ToolboxBodensee/diy-copter-remote/doc/datasheets/tiny_frsky_8ch_receiver_pinout.png

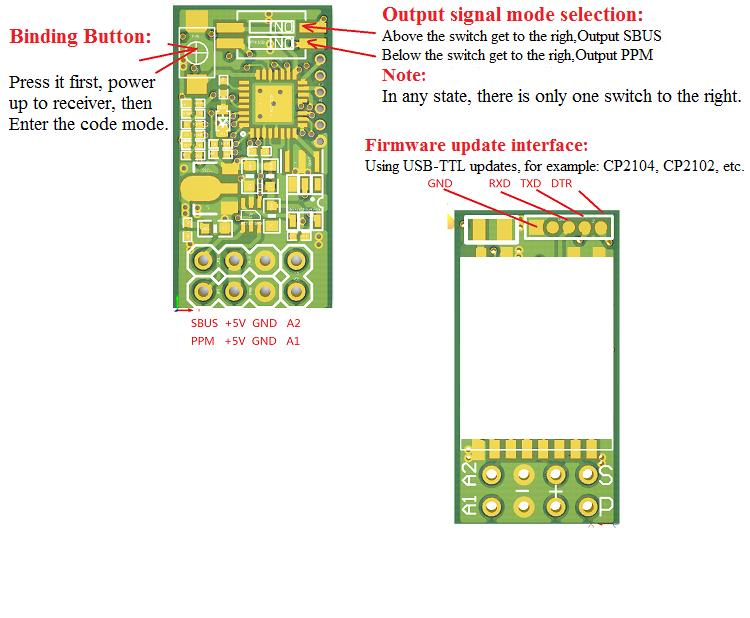
doc/datasheets/tiny_frsky_8ch_receiver_pinout.png
