ToolboxBodensee/diy-copter-remote/doc/remote/stm32_mod.jpg

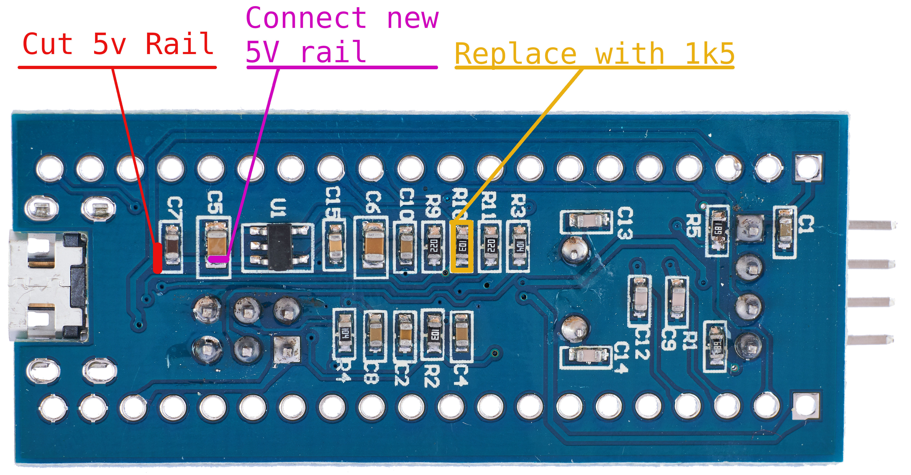
doc/remote/stm32_mod.jpg
