ToolboxBodensee/diy-copter-remote/doc/datasheets/pinout-pro_micro.jpg

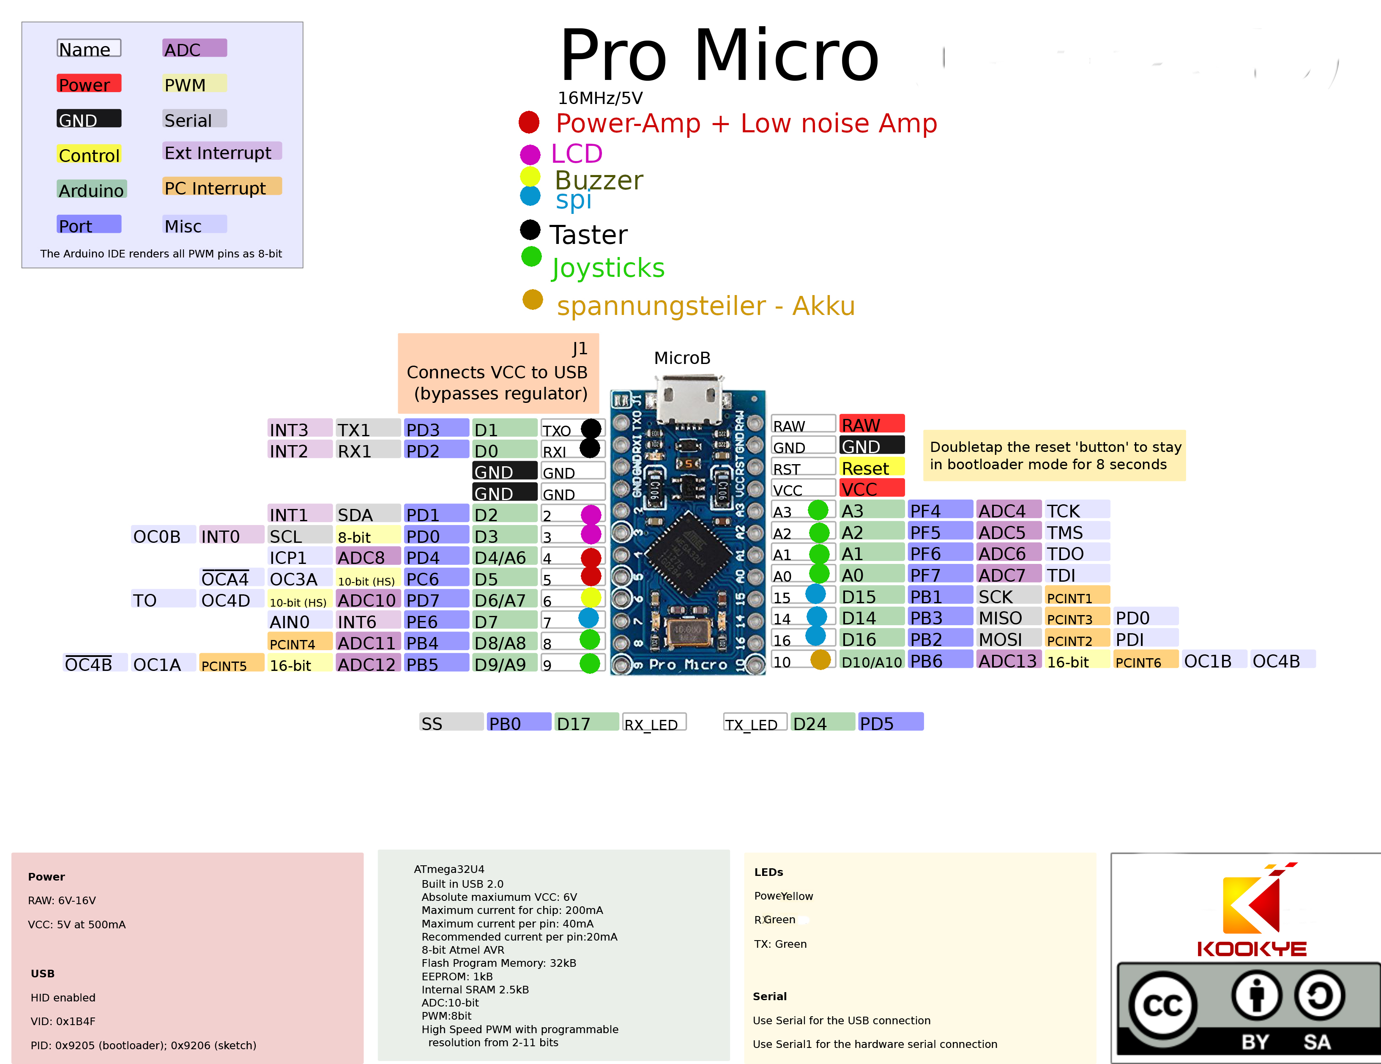
doc/datasheets/pinout-pro_micro.jpg
