ToolboxBodensee/diy-copter-remote/doc/coper/kosten.ods

Sheet: Kosten
Beschreibung | Link | Pro Teil Preis | Preis | Teile | Shop | Bestellung
Lötübungen
Linienfolgeroboter | DIY Robot (https://www.aliexpress.com/item/DIY-Robot-Smart-Car-Kit-Intelligent-Tracking-Line-Suite-TT-Motor-Electronic-Production-Tracing-Patrol-RC/32861091566.html) | $4.38 | $43.80 | 10
LED Tannenbaum | Three-Dimensional 3D Christmas Tree (https://www.aliexpress.com/item/Three-Dimensional-3D-Christmas-Tree-LED-DIY-Kit-Red-Green-Yellow-LED-Flash-Circuit-Kit-Electronic/32872841465.html) | $3.67 | $36.68 | 10
Quadrocopter + Funke für 5 kids + ersatz wegen china/kaputtlöten = 10 sets
Quadrocopter receiver | New Arrival Tiny Frsky 8CH Receiver Compatible With FRSKY X9D Plus DJT DFT DHT For QX90 DIY Micro Quadcopter (https://www.aliexpress.com/item/New-Arrival-Tiny-Frsky-8CH-Receiver-Compatible-With-FRSKY-X9D-Plus-DJT-DFT-DHT-For-QX90/32825660138.html) | $7.89 | $23.68 | 3 | aliexpress | 1
Funken Sender | CC2500 PA LNA (https://www.aliexpress.com/item/CC2500-PA-LNA-Romote-Wireless-Module-CC2500-SI4432-For-RC-Quadcopter-Helicopter-Multirotor-Model-Parts/32740098548.html) | $4.93 | $29.58 | 6 | aliexpress | 1
Funken Gas Hebel | Fast Free Ship 20pcs Potentiometer/Aircraft game 10K Throttle (https://www.aliexpress.com/item/Fast-Free-Ship-20pcs-Potentiometer-Aircraft-game-10K-Throttle-Potentiometer-Rocker-and-Joysticks/32652387867.html) | $1.45 | $28.93 | 20 | aliexpress | 1
Funken LCD | Geekcreit® IIC / I2C 1602 Blue Backlight LCD Display Screen... (https://www.banggood.com/IIC-I2C-1602-Blue-Backlight-LCD-Display-Module-For-Arduino-p-950726.html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) | $3.91 | $15.64 | 4 | bangood | 2
Propeller schwarz | 10 Pairs Kingkong 65mm Blade Propeller Prop 20Pcs for 720 8520 Coreless Motor DIY Micro Quadcopter (https://www.banggood.com/10-Pairs-Kingkong-65mm-Blade-Propeller-Prop-20Pcs-for-720-8520-Coreless-Motor-DIY-Micro-Quadcopter-p-1092166.html) | $4.99 | $9.98 | 2 | bangood | 2
Funken Sender | CC2500 PA LNA (https://www.banggood.com/CC2500-PA-LNA-Romote-Wireless-Module-CC2500-SI4432-NRF24L01-p-922595.html) | $4.69 | $23.45 | 5 | bangood | 2
Versandkosten | Bangood – Bestellnummer 2 | $3.03 | $3.03 | 1 | bangood | 2
Quadrocopter LED | Eachine Lizard105S FPV Racing Drone Spare Part Ultralight Colorful LED Alarm Buzzer WS2812B Programa (https://www.banggood.com/Eachine-Lizard105S-FPV-Racing-Drone-Spare-Part-Ultralight-Colorful-LED-Alarm-Buzzer-WS2812B-Programa-p-1262951.html) | $2.73 | $10.92 | 4 | bangood | 3
Quadrocopter receiver | Tiny Frsky 8CH Receiver Compatible With FRSKY X9D (https://www.banggood.com/Tiny-Frsky-8CH-Receiver-Compatible-With-FRSKY-X9D-Plus-DJT-DFT-DHT-For-QX90-DIY-Micro-Quadcopter-p-1079963.html) | $8.61 | $34.44 | 4 | bangood | 3
Quadrocopter FC/ESC | Realacc F3 V1.0 Betaflight Brushed Flight Control Board Integrated OSD with Buzzer STM32 F303 (https://www.banggood.com/Realacc-F3-V1_0-Betaflight-Brushed-Flight-Control-Board-Integrated-OSD-with-Buzzer-STM32-F303-MPU600-p-1121378.html) | $15.47 | $61.88 | 4 | bangood | 3
Quadrocopter Motoren | 4X Racerstar 8520 8.5x20mm 53500RPM Coreless Motor for Eachine QX80 DIY FPV Quadcopter (https://www.banggood.com/4X-Racerstar-8520-8_5x20mm-53500RPM-Coreless-Motor-for-Eachine-QX80-QX90-QX95-DIY-FPV-Quadcopter-p-1114280.html) | $12.53 | $50.12 | 4 | bangood | 3
Quadrocopter USB Ladegerät | 6CH USB To 3.7V 1S Lipo Battery Charging Adapter Board (https://www.banggood.com/6CH-USB-To-3_7V-1S-Lipo-Battery-Charging-Adapter-Board-p-1195277.html) | $4.40 | $35.20 | 8 | bangood | 3
Versandkosten | Bangood – Bestellnummer 3 | $6.53 | $6.53 | 1 | bangood | 3
Funken LCD I2c Controller | 5Pcs IIC/I2C/TWI/SPI Serial Port Module 5V 1602LCD Display For... (https://www.banggood.com/5Pcs-IICI2CTWISP-Serial-Module-Port-For-5V-Arduino-1602LCD-Display-p-964315.html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) | $0.89 | $4.46 | 5 | bangood | 4
Quadrocopter USB Ladegerät | 6CH USB To 3.7V 1S Lipo Battery Charging Adapter Board (https://www.banggood.com/6CH-USB-To-3_7V-1S-Lipo-Battery-Charging-Adapter-Board-p-1195277.html?rmmds=myorder) | $4.69 | $9.38 | 2 | bangood | 5
Funken Schalter | Wendao MTS-102 ON/ON SPDT AC 125V 6A 3 Pins Toggle Rocker Switch... (https://www.banggood.com/Wendao-MTS-102-ONON-SPDT-AC-125V-6A-3-Pins-Toggle-Rocker-Switch-10pcs-p-1060404.html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) | $0.37 | $18.55 | 50 | bangood | 6
Funken Hebel ( nick /Roll) | 20Pcs PS2 Game Joystick Module For Arduino (https://www.banggood.com/20Pcs-PS2-Game-Joystick-Module-For-Arduino-p-951191.html?rmmds=myorder) | $0.75 | $14.99 | 20 | bangood | 7
Quadrocopter USB Ladegerät | 6CH USB To 3.7V 1S Lipo Battery Charging Adapter Board (https://www.banggood.com/6CH-USB-To-3_7V-1S-Lipo-Battery-Charging-Adapter-Board-p-1195277.html?rmmds=myorder) | $4.69 | $9.38 | 2 | bangood | 8
Quadrocopter LED | Eachine Lizard105S FPV Racing Drone Spare Part Ultralight... (https://www.banggood.com/Eachine-Lizard105S-FPV-Racing-Drone-Spare-Part-Ultralight-Colorful-LED-Alarm-Buzzer-WS2812B-Programa-p-1262951.html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) | $2.73 | $16.38 | 6 | bangood | 8
Funken Antenne | 5pcs 2.4GHz 6dBi 50ohm Wireless Wifi Omni Copper Dipole Antenna (https://www.banggood.com/5pcs-2_4GHz-6dBi-50ohm-Wireless-Wifi-Omni-Copper-Dipole-Antenna-SMA-To-IPEX-For-Monitoring-Router-p-1214974.html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) | $2.24 | $22.42 | 10 | bangood | 9
Versandkosten | Bangood – Bestellnummer 9 | $0.67 | $0.67 | 1 | bangood | 9
Quadrocopter USB Ladegerät | 6CH USB To 3.7V 1S Lipo Battery Charging Adapter Board (https://www.banggood.com/6CH-USB-To-3_7V-1S-Lipo-Battery-Charging-Adapter-Board-p-1195277.html?rmmds=myorder) | $4.69 | $9.38 | 2 | bangood | 10
Propeller rot | 10 Pairs Kingkong 65mm Blade Propeller Prop 20Pcs for 720 8520... (https://www.banggood.com/10-Pairs-Kingkong-65mm-Blade-Propeller-Prop-20Pcs-for-720-8520-Coreless-Motor-DIY-Micro-Quadcopter-p-1092166.html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) | $2.99 | $8.97 | 3 | bangood | 10
Propeller schwarz | 10 Pairs Kingkong 65mm Blade Propeller Prop 20Pcs for 720 8520... (https://www.banggood.com/10-Pairs-Kingkong-65mm-Blade-Propeller-Prop-20Pcs-for-720-8520-Coreless-Motor-DIY-Micro-Quadcopter-p-1092166.html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) | $2.99 | $8.97 | 3 | bangood | 10
Quadrocopter receiver | Tiny Frsky 8CH Receiver Compatible With FRSKY X9D Plus DJT DFT... (https://www.banggood.com/Tiny-Frsky-8CH-Receiver-Compatible-With-FRSKY-X9D-Plus-DJT-DFT-DHT-For-QX90-DIY-Micro-Quadcopter-p-1079963.html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) | $8.61 | $34.44 | 4 | bangood | 10
Funken Controller | 5Pcs STM32F103C8T6 Small System Board Microcontroller STM32 ARM.. (https://www.banggood.com/5Pcs-STM32F103C8T6-Small-System-Board-Microcontroller-STM32-ARM-Core-Board-For-Arduino-p-1163842.html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) | $2.78 | $27.78 | 10 | bangood | 10
Quadrocopter Motoren | 4X Racerstar 8520 8.5x20mm 53500RPM Coreless Motor for Eachine (https://www.banggood.com/4X-Racerstar-8520-8_5x20mm-53500RPM-Coreless-Motor-for-Eachine-QX80-QX90-QX95-DIY-FPV-Quadcopter-p-1114280.html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) | $12.53 | $75.18 | 6 | bangood | 10
Quadrocopter FC/ESC | Realacc F3 V1.0 Betaflight Brushed Flight Control Board (https://www.banggood.com/Realacc-F3-V1_0-Betaflight-Brushed-Flight-Control-Board-Integrated-OSD-with-Buzzer-STM32-F303-MPU600-p-1121378.html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) | $15.47 | $92.82 | 6 | bangood | 10
Versandkosten | Bangood – Bestellnummer 10 | $7.84 | $7.84 | 1 | bangood | 10
Funken Spannungsversorgung | 5V 2.1A Charge Discharge Boost Power Modul 3.7V 4.2V Li-Ion 18650 LED Akku (https://www.ebay.de/itm/5V-2-1A-Charge-Discharge-boost-Power-Module-3-7V-4-2V-li-ion-18650-LED-battery/332653510696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) | 2.20 € | 13.22 € | 6 | ebay | 11
Funken Spannungsversorgung | 5V 2.1A Charge Discharge Boost Power Modul 3.7V 4.2V Li-Ion 18650 LED Akku (https://www.ebay.de/itm/5V-2-1A-Charge-Discharge-boost-Power-Module-3-7V-4-2V-li-ion-18650-LED-battery/332653510696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) | 2.20 € | 8.81 € | 4 | ebay | 12
Quadrocopter Akku | https://hobbyking.com/de_de/turnigy-nano-tech-750mah-1s-35-70c-lipo-pack-walkera-v120d02s-qr-infra-x-qr-w100s.html | 2.98 € | 62.58 € | 21 | hobbyking | 13
Quadrocopter Akku | https://hobbyking.com/de_de/turnigy-nano-tech-750mah-1s-35-70c-lipo-pack-walkera-v120d02s-qr-infra-x-qr-w100s.html | 2.94 € | 61.74 € | 21 | hobbyking | 14
Prototyp |  | #DIV/0!
Quadrocopter FC/ESC | Realacc F3 V1.0 Betaflight Brushed Flight Control Board Integrated OSD with Buzzer STM32 F303 MPU600 (https://www.banggood.com/Realacc-F3-V1_0-Betaflight-Brushed-Flight-Control-Board-Integrated-OSD-with-Buzzer-STM32-F303-MPU600-p-1121378.html) | 14.13 € | 14.13 € | 1 | bangood | 13
Versandkosten | Bangood – Bestellnummer 13 | 3.32 € | 3.32 € | 1 | bangood | 13
Quadrocopter akku | 6PCS ZOP POWER 3.7V 600mAh 30C 1S Lipo Battery JST Plug With... (https://www.banggood.com/6PCS-ZOP-POWER-3_7V-600mAh-30C-1S-Lipo-Battery-JST-Plug-With-Charger-For-RC-Models-p-1329943.html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) | 15.01 € | 15.01 € | 1 | bangood | 14
Versandkosten | Bangood – Bestellnummer 14 | 2.73 € | 2.73 € | 1 | bangood | 14
Propeller rot | 10 Pairs Kingkong 65mm Blade Propeller Prop 20Pcs for 720 8520 (https://www.banggood.com/10-Pairs-Kingkong-65mm-Blade-Propeller-Prop-20Pcs-for-720-8520-Coreless-Motor-DIY-Micro-Quadcopter-p-1092166.html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) | 4.41 € | 4.41 € | 1 | bangood | 15
Propeller schwarz | 10 Pairs Kingkong 65mm Blade Propeller Prop 20Pcs for 720 8520... (https://www.banggood.com/10-Pairs-Kingkong-65mm-Blade-Propeller-Prop-20Pcs-for-720-8520-Coreless-Motor-DIY-Micro-Quadcopter-p-1092166.html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) | 4.41 € | 4.41 € | 1 | bangood | 15
Quadrocopter receiver | Tiny Frsky 8CH Receiver Compatible With FRSKY X9D Plus DJT DFT... (https://www.banggood.com/Tiny-Frsky-8CH-Receiver-Compatible-With-FRSKY-X9D-Plus-DJT-DFT-DHT-For-QX90-DIY-Micro-Quadcopter-p-1079963.html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) | 7.94 € | 7.94 € | 1 | bangood | 15
Quadrocopter Motoren | 4X Racerstar 8520 8.5x20mm 53500RPM Coreless Motor for Eachine. (https://www.banggood.com/4X-Racerstar-8520-8_5x20mm-53500RPM-Coreless-Motor-for-Eachine-QX80-QX90-QX95-DIY-FPV-Quadcopter-p-1114280.html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) | 11.48 € | 11.48 € | 1 | bangood | 15
Versandkosten | Bangood – Bestellnummer 15 | 3.91 € | 3.91 € | 1 | bangood | 15
Funken Spannungsversorgung | 3Pcs LM2596 DC-DC Adjustable Step Down Power Supply Module (https://www.banggood.com/3Pcs-LM2596-DC-DC-Adjustable-Step-Down-Power-Supply-Module-p-1029697.html) | 3.31 € | 3.31 € | 1 | bangood | 16
Logic Konverter | RobotDyn® 4 Chanels Logic Level Converter High Speed Bi-Directional 3.3V-5V (https://www.banggood.com/4-Chanels-Logic-Level-Converter-High-Speed-Bi-Directional-3_3V-5V-p-1243719.html) | 1.29 € | 1.29 € | 1 | bangood | 16
Quadrocopter Antenne | 3DBI Brass 2.4G Receiver Antenna Omni Directional IPEX Port Compatible Futaba JR WFLY (https://www.banggood.com/3DBI-Brass-2_4G-Receiver-Antenna-Omnidirectional-IPEX-Port-Compatible-Futaba-JR-WFLY-p-1032401.html) | 1.37 € | 1.37 € | 1 | bangood | 16
Funken Joysticks | 5Pcs PS2 Game Joystick Module For Arduino (https://www.banggood.com/5Pcs-PS2-Game-Joystick-Module-For-Arduino-p-951186.html) | 4.15 € | 4.15 € | 1 | bangood | 16
Funken Controller | Pro Micro 5V 16M Mini Leonardo Microcontroller Development Board For Arduino (https://www.banggood.com/Pro-Micro-5V-16M-Mini-Leonardo-Microcontroller-Development-Board-For-Arduino-p-1077675.html) | 6.72 € | 6.72 € | 1 | bangood | 16
Funken Sender | CC2500 PA LNA Romote Wireless Module CC2500 SI4432 (https://www.banggood.com/CC2500-PA-LNA-Romote-Wireless-Module-CC2500-SI4432-NRF24L01-p-922595.html) | 4.41 € | 4.41 € | 1 | bangood | 16
Versandkosten | Bangood – Bestellnummer 16 | 2.48 € | 2.48 € | 1 | bangood | 16
PLA Filament |  | 23.99 € | 47.98 € | 2 | amazon
 |  | SUMME | $775.47
 |  |  | 285.40 €
 |  | Umrechnungkurs Dollar zu Euro (stand 20 Dec)
 |  | 0,87
 |  | SUMME | 960.06 €

Sheet: Zeiten
Bescreibung | Datum | Stunden | Philipp |  | Thomas |  | Alex |  | Mara
Vorbereitung
Teile zusammenstellen + Bestellungen |  | 7 | x | 7 | x | 7 |  | 0 |  | 0
Prototypen 3d model |  | 10 | x | 10 | x | 10 |  | 0 |  | 0
Programmierung Funke |  | 18 | x | 18 |  | 0 | x | 18 |  | 0
Kurszusammenstellung |  | 5 | x | 5 | x | 5 | x | 5 |  | 0
Bescreibung | Datum | Stunden | Philipp | 0 | Thomas |  | Alex |  | Mara
Kurs Inhalt
Kurs 1 Kennenlernen | 08.11.18 | 2 | x | 2 | x | 2 | x | 2 | x | 2
Kurs 2 Simulator | 15.11.18 | 2 | x | 2 | x | 2 | x | 2 | x | 2
Kurs 3 Lötkolben | 22.11.18 | 2 | x | 2 | x | 2 | x | 2 | x | 2
Kurs 4 Linien-folge | 29.11.18 | 2 | x | 2 | x | 2 | x | 2 | x | 2
Kurs 5 Linien-folge | 06.12.18 | 3 | x | 3 | x | 3 | x | 3 | x | 3
Kurs 6 Weihnachtsledbaum | 13.12.18 | 2 | x | 2 |  | 0 | x | 2 | x | 2
Kurs 7 Weihnachtsledbaum | 20.12.18 | 2 | x | 2 | x | 2 | x | 2 | x | 2
Kurs 8 Quadrocopter | 10.01.19 | 2 | x | 2 | x | 2 | x | 2 | x | 2
Kurs 9 Holzgehäuse für die Fernsteuerung | 17.01.19 | 2 | x | 2 | x | 2 | x | 2 | x | 2
Kurs 10 Löten Fernsteuerung | 24.01.19 | 2 | x | 2 | x | 2 | x | 2 | x | 2
Kurs 11 Fernsteuerung | 31.01.19 | 2 | x | 2 | x | 2 | x | 2 | x | 2
Kurs 12 Erstes Fliegen | 07.02.19 | 2 | x | 2 | x | 2 | x | 2 | x | 2
Kurs 13 Manövrieren des Quadrocopters | 14.02.19 | 2 | x | 2 | x | 2 | x | 2 | x | 2
Kurs 14 Manövrieren des Quadrocopters | 21.02.19 | 2 | x | 2 | x | 2 | x | 2 | x | 2
Kurs 15 Wettrennen? | 28.02.19 | 2 | x | 2 | x | 2 | x | 2 | x | 2
SUMME |  |  | 71 | 0 | 51 |  | 54 |  | 31
