ToolboxBodensee/diy-copter-remote/3d/quad_plug.stl

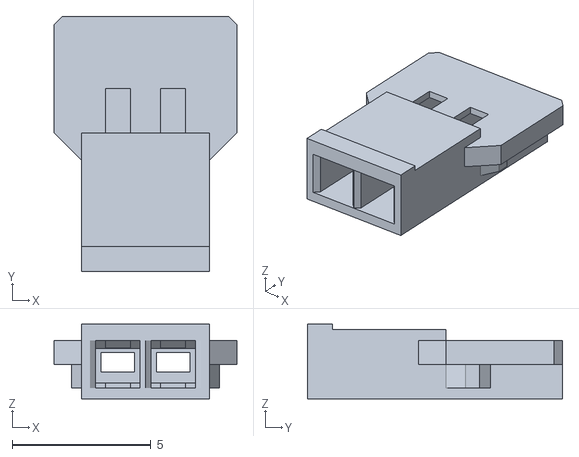
[picture p4: CAD file, 2019-02-28]
3d/quad_plug.stl
6.60 x 9.20 x 2.70
