ToolboxBodensee/diy-copter-remote/(list of files, cad)

Other CAD files:
3d/510050200.stp
