ToolboxBodensee/diy-copter-remote/doc/remote/remote_eschema.pdf

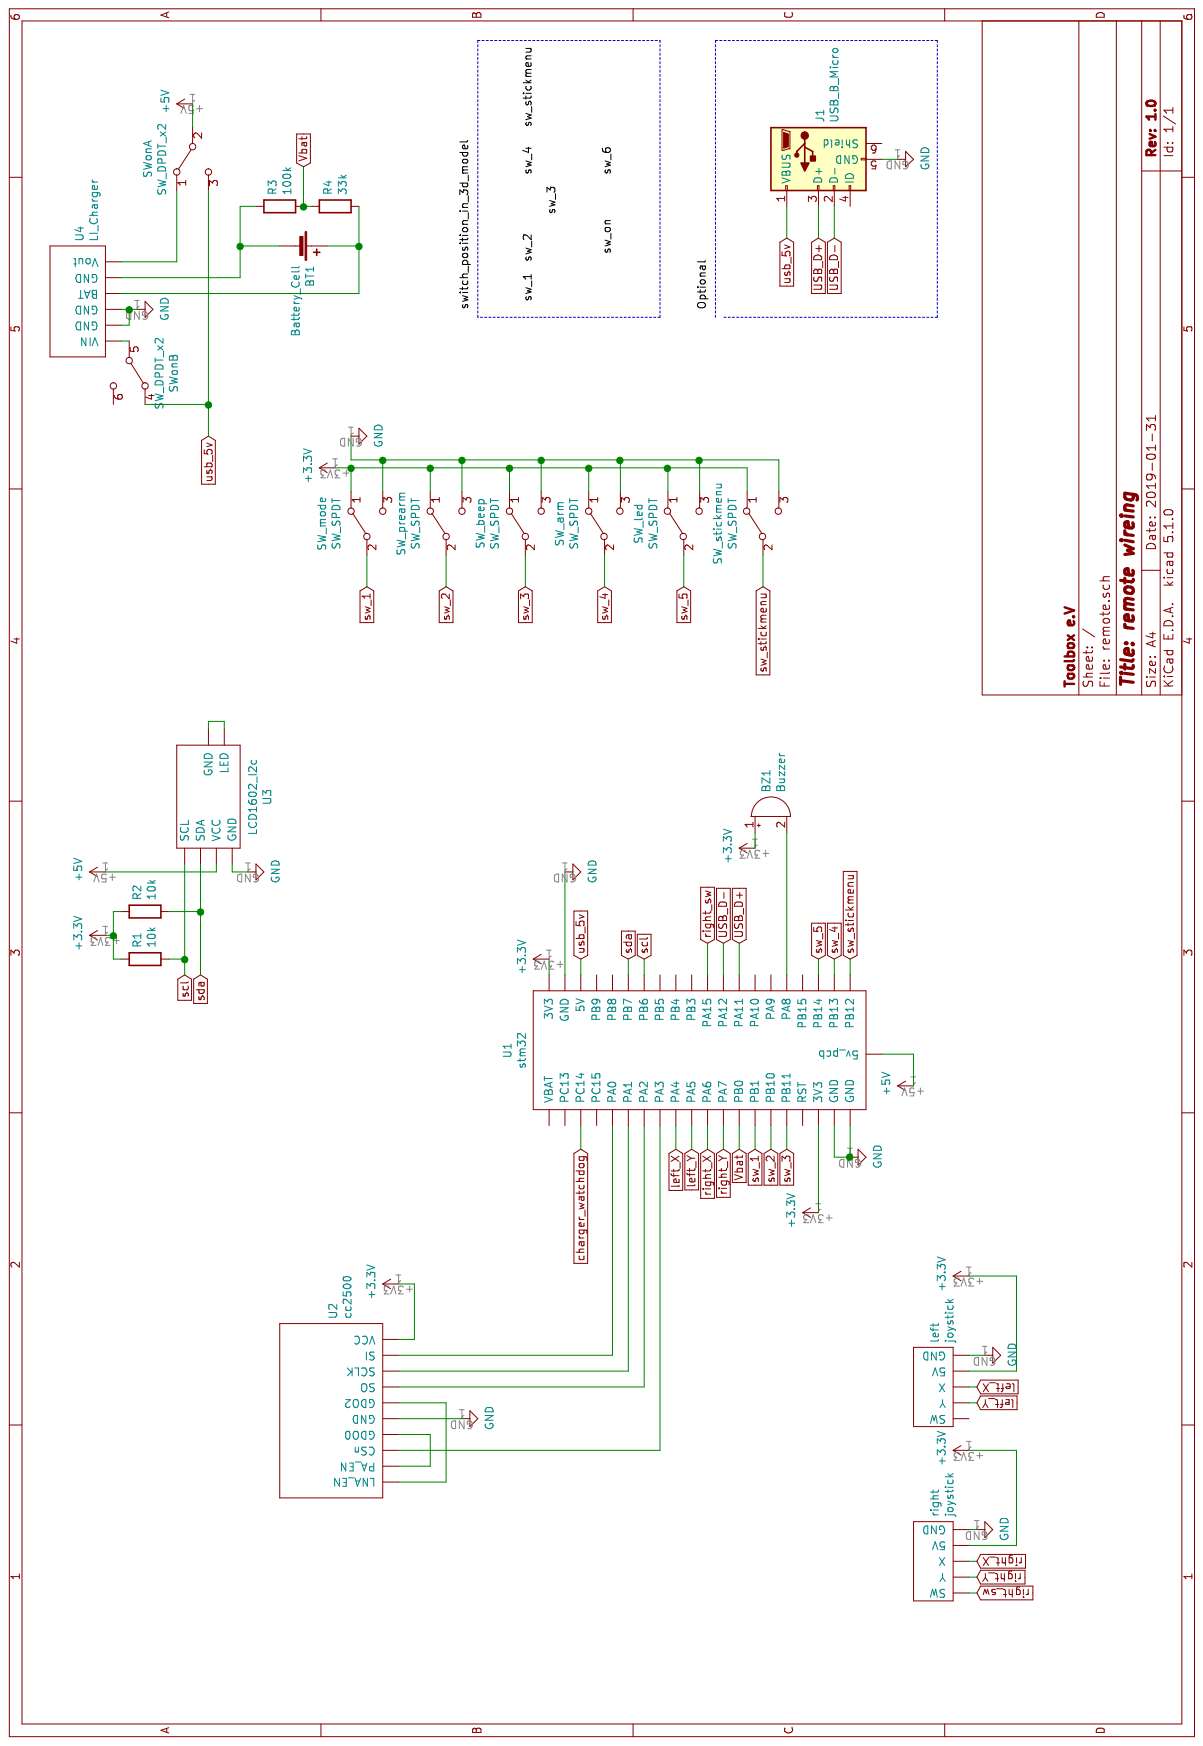
[picture p5: page 1]
