ToolboxBodensee/diy-copter-remote/remote/include/tx_def.h

#ifndef _TX_DEV_H_
#define _TX_DEV_H_

//Channel MIN MAX values
#define CHANNEL_MAX_100 1844    //  100%
#define CHANNEL_MIN_100 204     //  100%
#define CHANNEL_MAX_125 2047    //  125%
#define CHANNEL_MIN_125 0       //  125%

#define CHANNEL_MIN_COMMAND 784     // 1350us
#define CHANNEL_SWITCH      1104    // 1550us
#define CHANNEL_MAX_COMMAND 1424    // 1750us

//Channel definitions


#endif /* _TX_DEV_H_ */
