ToolboxBodensee/diy-copter-remote/remote/src/state_init.cpp

#include <LiquidCrystal_I2C.h>
#include <stdio.h>
#include "Arduino.h"
#include "FrSkyD_cc2500.h"
#include "state.h"
#include "input.h"
#include "eeprom.h"
#include "debug.h"
#include "config.h"
#include "pins.h"
#include "tx_def.h"

LCD_state_init::LCD_state_init(void) {
}
void LCD_state_init::enter(void) {
    lcd.clear();
    lcd.setCursor(0,0);
    lcd.print("     welcome    ");
    lcd.setCursor(0,1);
    lcd_centerText(REMOE_OWNER);

    this->time_enter = millis();
    BUZZER_output;

    /* for(int i = 0 ; i < 10;++i) { */
    /*     delay(100); */
    /*     BUZZER_on; */
    /*     delay(100); */
    /*     BUZZER_off; */
    /*     delay(100); */
    /* } */
}

void LCD_state_init::update(void)
{
    uint32_t diff;
    delay(100);
    diff = millis() - this->time_enter;
    if (diff > 3 * 1000) {
        new_state = s_joy;
        debugln("read start");
        delay(1000);
        if ( 0  > eeprom_config.read()) {
            debugln("failed to read");
            return;
        }
        debugln("read fin");

        debugln("val start");
        if ( 0  > eeprom_config.validate()) {
            debugln("failed to validate");
            return;
        }
        debugln("val fin");

        new_state = s_menu;

        struct Input::ch_config ch_config[Input::CH_COUNT];
        eeprom_config.get_ch_config(ch_config);
        input.set_calibration(ch_config);

        uint32_t master_id = 0;
        eeprom_config.get_master_id(&master_id);
        set_rx_tx_addr(master_id);

        uint8_t freq_ = 0;
        eeprom_config.get_freq_offset(&freq_);
        freq_offset = freq_;

    }
}

void LCD_state_init::leave(void)
{
    lcd.clear();
}
