ToolboxBodensee/diy-copter-remote/Multiprotocol/FrSkyV_cc2500.ino

/*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
 You should have received a copy of the GNU General Public License
 along with Multiprotocol.  If not, see <http://www.gnu.org/licenses/>.
 */

#if defined(FRSKYV_CC2500_INO)

#define FRSKYV_BIND_COUNT 200

enum {
    FRSKYV_DATA1=0,
    FRSKYV_DATA2,
    FRSKYV_DATA3,
    FRSKYV_DATA4,
    FRSKYV_DATA5
};


#include "iface_cc2500.h"
static uint8_t __attribute__((unused)) FRSKYV_crc8(uint8_t result, uint8_t *data, uint8_t len)
{
    for(uint8_t i = 0; i < len; i++)
    {
        result = result ^ data[i];
        for(uint8_t j = 0; j < 8; j++)
            if(result & 0x80)
                result = (result << 1) ^ 0x07;
            else
                result = result << 1;
    }
    return result;
}

static uint8_t __attribute__((unused)) FRSKYV_crc8_le(uint8_t *data, uint8_t len)
{
    uint8_t result = 0xD6;

    for(uint8_t i = 0; i < len; i++)
    {
        result = result ^ data[i];
        for(uint8_t j = 0; j < 8; j++)
            if(result & 0x01)
                result = (result >> 1) ^ 0x83;
            else
                result = result >> 1;
    }
    return result;
}

static void __attribute__((unused)) FRSKYV_build_bind_packet()
{
    //0e 03 01 57 12 00 06 0b 10 15 1a 00 00 00 61
    packet[0] = 0x0e;                //Length
    packet[1] = 0x03;                //Packet type
    packet[2] = 0x01;                //Packet type
    packet[3] = rx_tx_addr[3];
    packet[4] = rx_tx_addr[2];
    packet[5] = (binding_idx % 10) * 5;
    packet[6] = packet[5] * 5 + 6;
    packet[7] = packet[5] * 5 + 11;
    packet[8] = packet[5] * 5 + 16;
    packet[9] = packet[5] * 5 + 21;
    packet[10] = packet[5] * 5 + 26;
    packet[11] = 0x00;
    packet[12] = 0x00;
    packet[13] = 0x00;
    packet[14] = FRSKYV_crc8(0x93, packet, 14);
}

static uint8_t __attribute__((unused)) FRSKYV_calc_channel()
{
    uint32_t temp=seed;
    temp = (temp * 0xaa) % 0x7673;
    seed = temp;
    return (seed & 0xff) % 0x32;
}

static void __attribute__((unused)) FRSKYV_build_data_packet()
{
    uint8_t idx = 0;            // transmit lower channels

    packet[0] = 0x0e;
    packet[1] = rx_tx_addr[3];
    packet[2] = rx_tx_addr[2];
    packet[3] = seed & 0xff;
    packet[4] = seed >> 8;
    if (phase == FRSKYV_DATA1 || phase == FRSKYV_DATA3)
        packet[5] = 0x0f;
    else
        if(phase == FRSKYV_DATA2 || phase == FRSKYV_DATA4)
        {
            packet[5] = 0xf0;
            idx=4;              // transmit upper channels
        }
        else
            packet[5] = 0x00;
    for(uint8_t i = 0; i < 4; i++)
    {
        uint16_t value = convert_channel_frsky(i+idx);
        packet[2*i + 6] = value & 0xff;
        packet[2*i + 7] = value >> 8;
    }
    packet[14] = FRSKYV_crc8(crc8, packet, 14);
}

uint16_t ReadFRSKYV()
{
    if(IS_BIND_DONE)
    {   // Normal operation
        uint8_t chan = FRSKYV_calc_channel();
        CC2500_Strobe(CC2500_SIDLE);
        if (option != prev_option)
        {
            CC2500_WriteReg(CC2500_0C_FSCTRL0, option);
            prev_option=option;
        }
        CC2500_WriteReg(CC2500_0A_CHANNR, chan * 5 + 6);
        FRSKYV_build_data_packet();

        if (phase == FRSKYV_DATA5)
        {
            CC2500_SetPower();
            phase = FRSKYV_DATA1;
        }
        else
            phase++;

        CC2500_WriteData(packet, packet[0]+1);
        return 9006;
    }
    // Bind mode
    FRSKYV_build_bind_packet();
    CC2500_Strobe(CC2500_SIDLE);
    CC2500_WriteReg(CC2500_0A_CHANNR, 0x00);
    CC2500_WriteData(packet, packet[0]+1);
    binding_idx++;
    if(binding_idx>=FRSKYV_BIND_COUNT)
        BIND_DONE;
    return 53460;
}

uint16_t initFRSKYV()
{
    //ID is 15 bits. Using rx_tx_addr[2] and rx_tx_addr[3] since we want to use RX_Num for model match
    rx_tx_addr[2]&=0x7F;
    crc8 = FRSKYV_crc8_le(rx_tx_addr+2, 2);

    FRSKY_init_cc2500(FRSKYV_cc2500_conf);
    seed = 1;
    binding_idx=0;
    phase = FRSKYV_DATA1;
    return 10000;
}

#endif
