ToolboxBodensee/diy-copter-remote/(commit log)

2018-08-25 Modified frame design and added some docs.
    [mgh-quad.scad]
2018-08-25 Tweaks to frame design
    [mgh-quad.scad]
2018-09-13 Redesigned quadcopter frame
    [mgh-quad.scad]
2018-09-28 multiprocol rename + try to fix timings + power
    [CC2500_SPI.ino, Common.ino, FrSkyD_cc2500.ino, FrSkyV_cc2500.ino, FrSkyX_cc2500.ino, Multiprotocol.h, Multiprotocol.ino, SPI.ino]
2018-10-04 go for esp32: - remove freq offset overwrite - remove delayMilliseconds - print if bind phase is over - add prescale factor (try with leonardo) - substract execution time from wait -> works only for 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
2018-11-08 new frame with motor flange
    [mgh-quad.scad]
2018-11-09 add akku mount
    [mgh-quad.scad]
2018-11-13 big cleanup for 3d print model frame
    [mgh-quad.scad, quad.scad]
2019-01-10 [3d-model] add names +toolbox
    [quad.scad]
2019-01-10 [stm32] change pinout add stmpinout pic add realacc fc datasheet
2019-01-10 cleanup + add handouts
    [kosten.ods]
2019-01-12 add 3d model for remote, antenna, i2c lcd and cc2500 design top plate in order to place the boards
    [remote.scad, stick.scad]
2019-01-13 add battery charger add holder for each pcb
    [remote.scad]
2019-01-13 add ps2 pcb
    [remote.scad, stick.scad]
2019-01-15 increase a bit the body of the remote add ps2 joystick screw holes and dust protector
    [remote.scad]
2019-01-15 add screw mounts and stap holder
    [remote.scad]
2019-01-16 add akku cable cut for led stip
    [quad.scad, remote.scad, stick.scad]
2019-01-22 add battery pos and holders and inner brim on top plate
    [quad.scad, remote.scad]
2019-01-23 remote: larger cutout for switches longer stems for lcd unify pcbsize paramerter
    [remote.scad]
2019-01-23 enforce lcd screw stems go for normal stem with screw
    [remote.scad]
2019-01-24 change quad motor size
    [quad.scad, remote.scad]
2019-01-25 remork bottom remote part in order to screw left/right grips
    [remote.scad]
2019-01-25 update cost table
    [kosten.ods, quad.scad]
2019-01-31 version 1.2 quad
    [quad.scad, remote.scad]
2019-01-31 add simple kicad for remote add threads scad lib add .stl to ignore
    [remote.kicad_pcb, remote.sch]
2019-01-31 add cylinder_square and cubic_flange
2019-02-10 add new keycad connection for the remote
    [remote.sch]
2019-02-27 add calibration of inputs
2019-02-27 add invert calibration
2019-02-27 add usb connector at better position for current remote top case since its already printed with incorrect position add gears lib
    [remote.scad]
2019-02-27 shorten sticks and add double pinout switch for on/off
    [remote.scad, stick.scad]
2019-02-28 move usb one tick up
    [remote.scad]
2019-02-28 add gears scad lib
2019-02-28 add stm32 pcb changs
2019-02-28 add charger plug for turnigy molex
    [510050200.stp, quad_charge_plug.scad, quad_plug.stl]
2019-03-14 add bootloader add eschema pdf and add optinal usb
    [remote.sch]
2019-03-14 update eschema
    [remote.sch]
2019-03-15 fixed usb connection issue - generic board config is needed for all the fancy usb things
2019-03-15 fixed a printing bug
    [state.cpp]
2019-03-20 rename kicad folder
    [remote.kicad_pcb, remote.sch]
2019-03-27 improve battery charger plug
    [quad_charge_plug.scad, stick.scad]
2019-03-27 Partially rework input/eeprom + further cleanup
    [FrSkyD_cc2500.cpp, FrSkyD_cc2500.h, Multiprotocol.cpp, Multiprotocol.h, common.cpp, crc.cpp, eeprom.cpp]
2019-04-02 Partially rework input/eeprom + further cleanup part2
    [FrSkyD_cc2500.cpp, FrSkyD_cc2500.h, Multiprotocol.cpp, Multiprotocol.h, Validate.h, cc2500_spi.cpp, config.h, crc.cpp]
2019-04-03 fix eeprom and add fly state implementation
    [FrSkyD_cc2500.cpp, FrSkyD_cc2500.h, Multiprotocol.cpp, eeprom.cpp, input.cpp, state.cpp, state.h, state_bind.cpp]
2019-04-04 fix inverting of channels
    [input.cpp]
2019-04-11 update charge plug and config for motor mapping
    [quad_charge_plug.scad]
2019-04-11 add debug only in case of non joystick usb and vice versa
2019-04-16 add Makefile for 3d models
    [remote.scad, stick.scad]
2019-04-16 add sw on p/r add battery percentage
2019-04-16 fix kicad for x/y naming
    [remote.sch]
2019-04-16 change vbat to a analog pin
    [remote.sch]
2019-04-16 display freq offset since telemetry is not working
    [state.cpp, state_fly.cpp]
2019-04-29 fix typo + fix invert add min max check for dead range
    [config.h, eeprom.h, input.cpp, state_init.cpp]
2019-06-18 add cammount option for eachine tx06
    [quad.scad]
